tadtruex/PiPico/AirCar/kicad/AirCar-Proto/AirCar-Proto.kicad_pcb

## KiCad design AirCar/kicad/AirCar-Proto/AirCar-Proto.kicad_pcb (2024-01-03)

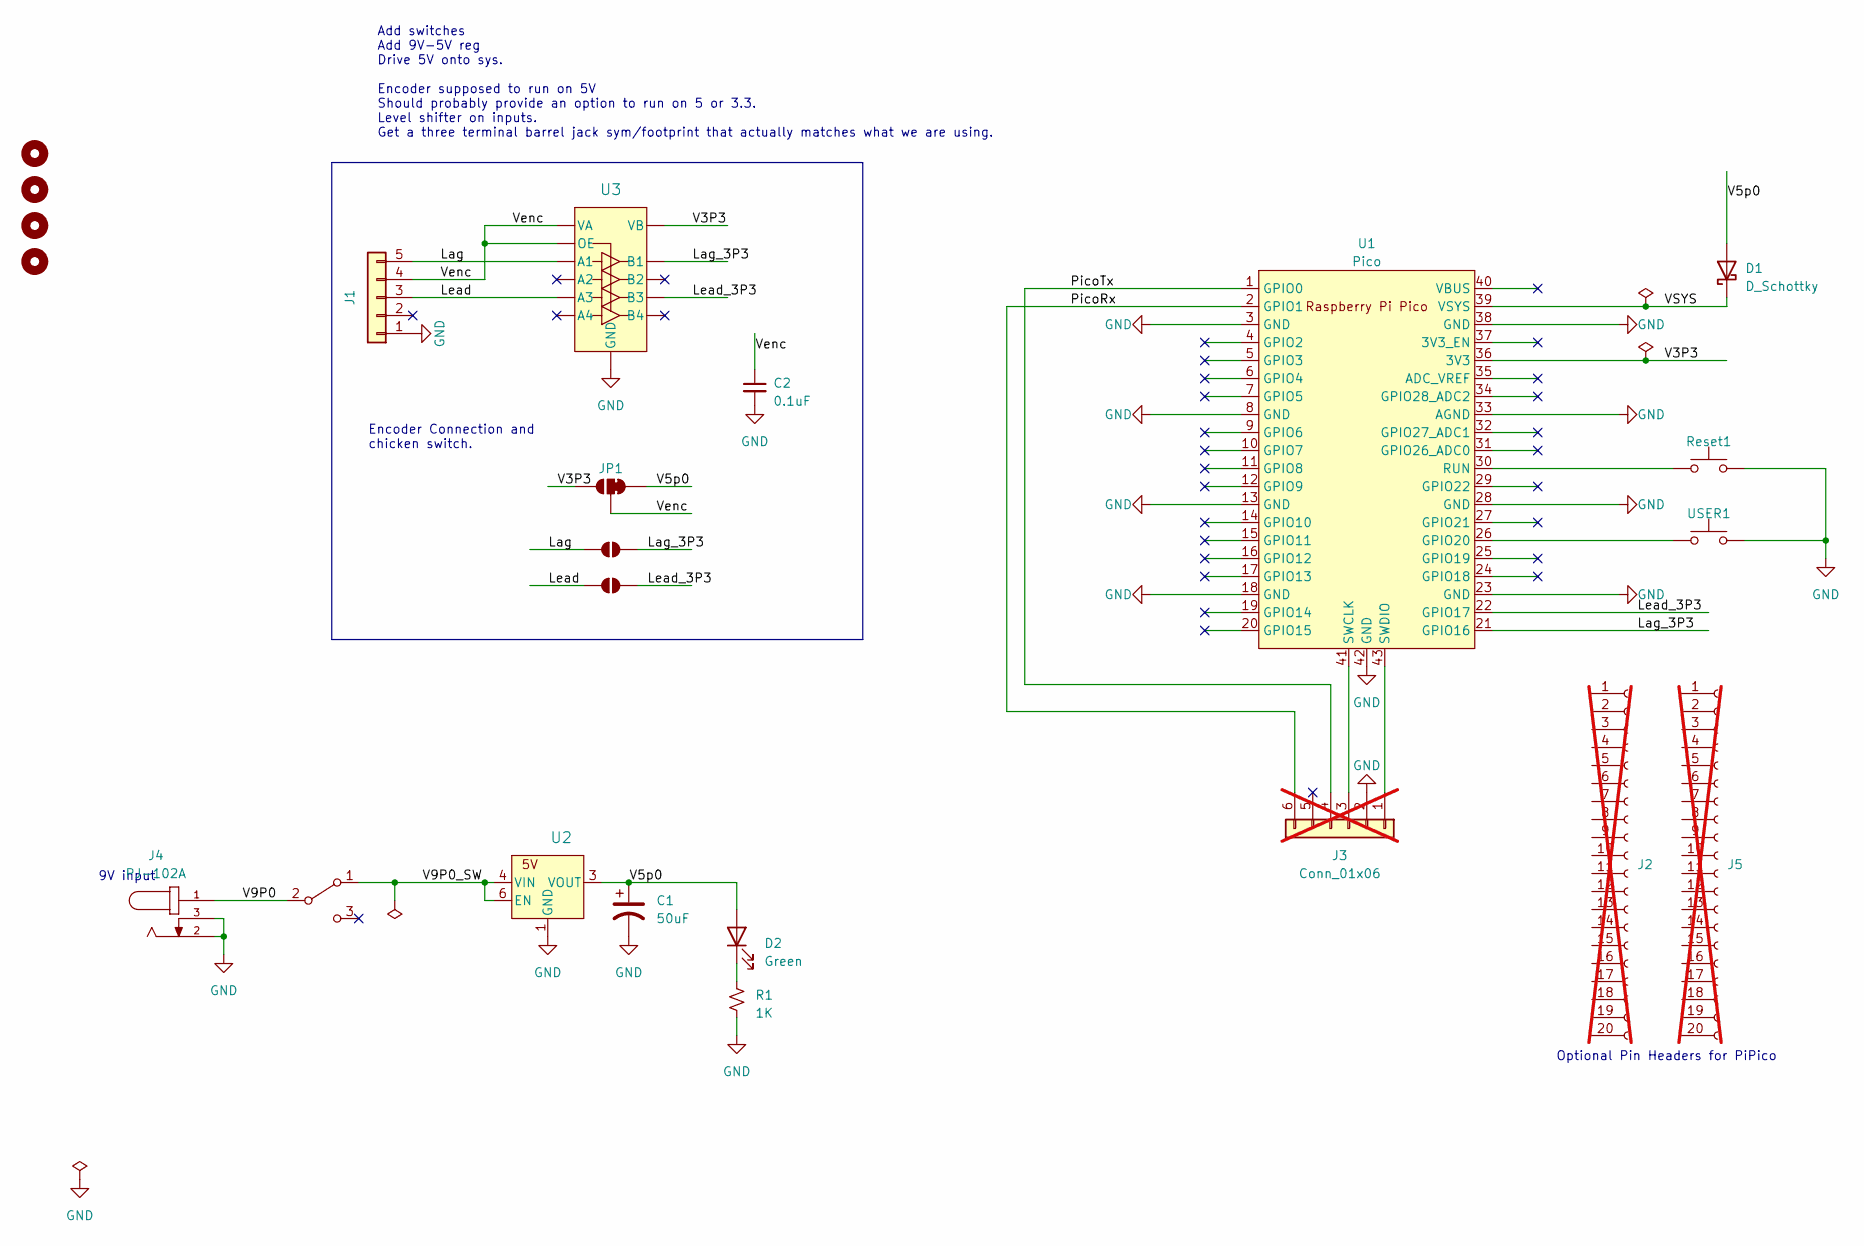
[picture p1: schematic AirCar-Proto.kicad_sch]

Parts:
C1: 50uF; CP_Radial_D8.0mm_P2.50mm
C2: 0.1uF; C_0603_1608Metric
D1: D_Schottky; D_SOD-123F; Digikey CRS01QCT-ND
D2: Green; LED_D5.0mm
H1, H2, H3, H4: MountingHole; MountingHole_3.2mm_M3
J1: Conn_01x05; PinHeader_1x05_P2.54mm_Horizontal; Digikey WM4903-ND
J2, J5: Conn_01x20_Socket; PinHeader_1x20_P2.54mm_Vertical; DigiKey 1212-1105-ND; not fitted
J3: Conn_01x06; PinHeader_1x06_P2.54mm_Horizontal; not fitted
J4: PJ-102A; BarrelJack_CUI_PJ-102AH_Horizontal; PART_REV 1.03
JP1: SolderJumper_3_Bridged12; SolderJumper-3_P1.3mm_Bridged12_RoundedPad1.0x1.5mm
JP2, JP3: SolderJumper_2_Open; SolderJumper-2_P1.3mm_Open_RoundedPad1.0x1.5mm
R1: 1K; R_0603_1608Metric
Reset1: SmallPushbutton; SW4_1825910-B_TEC; Digikey 450-1650-ND
SW2: SW_SPDT; CS12ANW03_NKK; Digikey 360-2131-ND
U1: Pico; RPi_Pico_SMD_TH; Digikey 2648-SC0915TR-ND
U2: LDL212PU50R; DFN-6-1EP_3x3mm_P0.95mm_EP1.7x2.6mm; Digikey 497-16897-2-ND
U3: TXU0104BQAR; U_TXU0104_TEX; Digikey 296-TXU0104BQARTR-ND
USER1: SmallPushbutton; SW4_1825910-B_TEC; Digikey 450-1650-ND

Connections:
/Lag: J1.5, JP2.1 (A), U3.2 (A1)
/Lag_3P3: JP2.2 (B), U1.21 (GPIO16), U3.13 (B1)
/Lead: J1.3, JP3.1 (A), U3.4 (A3)
/Lead_3P3: JP3.2 (B), U1.22 (GPIO17), U3.11 (B3)
/PicoRx: J3.6, U1.2 (GPIO1)
/PicoTx: J3.4, U1.1 (GPIO0)
/V3P3: JP1.3 (B), U1.36 (3V3), U3.14 (VB)
/V5p0: C1.1, D1.2 (A), D2.2 (A), JP1.1 (A), U2.2 (ADJ/sense), U2.3 (VOUT)
/V9P0: J4.1, SW2.2 (B)
/V9P0_SW: SW2.1 (A), U2.4 (VIN), U2.6 (EN)
/VSYS: D1.1 (K), U1.39 (VSYS)
/Venc: C2.1, J1.4, JP1.2 (C), U3.1 (VA), U3.8 (OE)
GND: C1.2, C2.2, J1.1, J3.2, J4.2, J4.3, R1.2, Reset1.3, Reset1.4, U1.3 (GND), U1.8 (GND), U1.13 (GND), U1.18 (GND), U1.23 (GND), U1.28 (GND), U1.33 (AGND), U1.38 (GND), U1.42 (GND), U2.1 (GND), U2.7 (GND), U3.7 (GND), U3.15 (GND), USER1.3, USER1.4
unnamed: D2.1 (K), R1.1
unnamed: J3.1, U1.43 (SWDIO)
unnamed: J3.3, U1.41 (SWCLK)
unnamed: U1.26 (GPIO20), USER1.1, USER1.2
unnamed: Reset1.1, Reset1.2, U1.30 (RUN)

Notes on the sheet:
Add switches Add 9V-5V reg Drive 5V onto sys. Encoder supposed to run on 5V Should probably provide an option to run on 5 or 3.3. Level shifter on inputs. Get a three terminal barrel jack sym/footprint that actually matches what we are using.
Optional Pin Headers for PiPico
9V input
Encoder Connection and chicken switch.

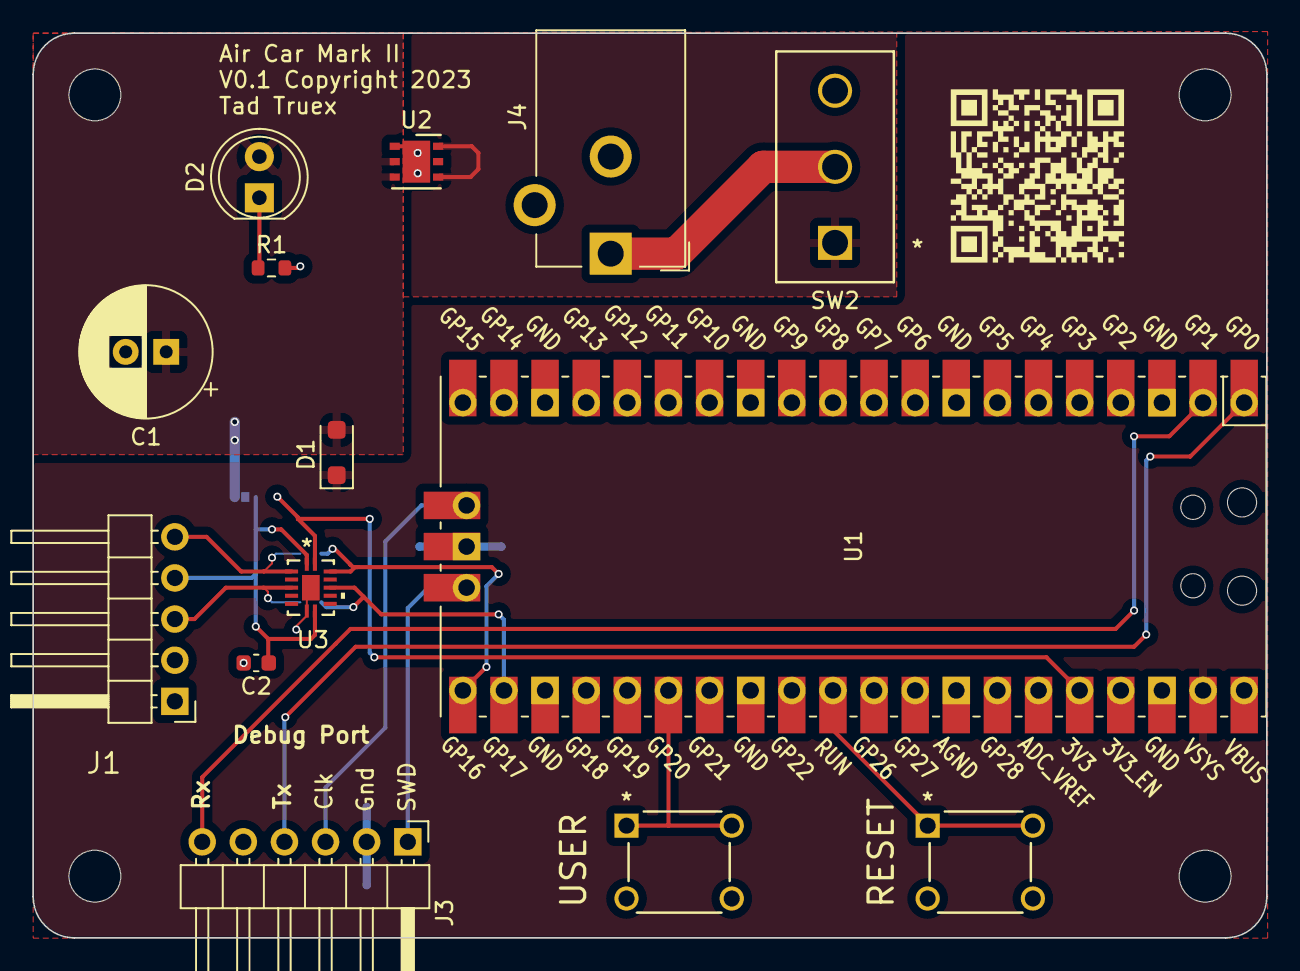
[picture p2: board AirCar-Proto.kicad_pcb from above]

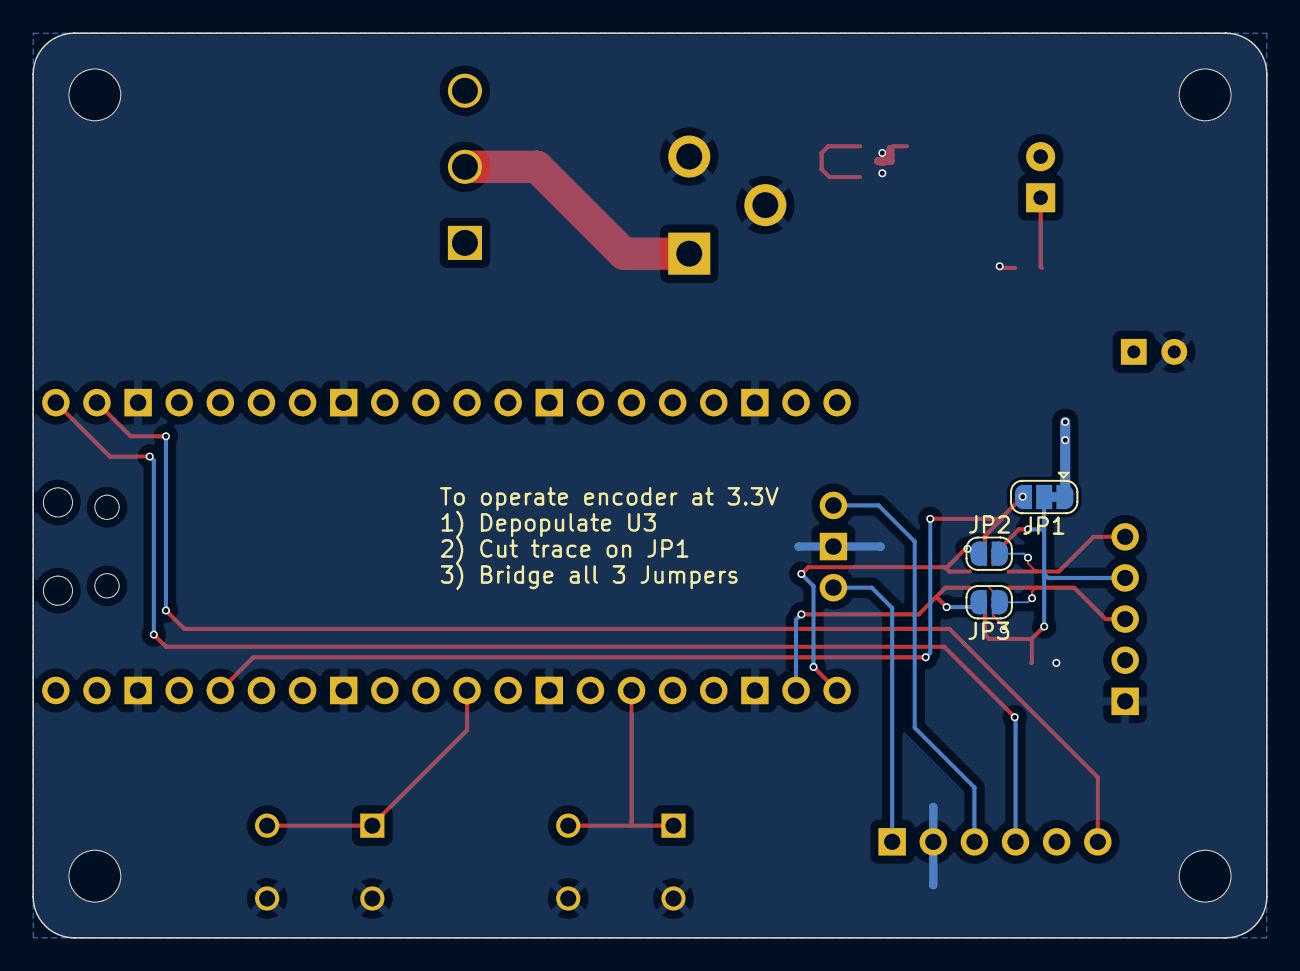
[picture p3: board AirCar-Proto.kicad_pcb from below]

Board: 2 copper layers, 76.2 x 55.9 mm, 21 parts (3 on the bottom side), 18 nets.
