tadtruex/PiPico/AirCar/aircar/aircar.c

/*
 * AirCar MarkII
 *
 * Tad Truex, F23
 *
 * Goals:
 * 	At a minimum, replicate the existing 8051 firmware.  Ideally,
 * 	modernize a bit, potentially adding additional sensors (accelerometer),
 * 	possibly a small display, an RTC, and (hopefully) eliminate the need for
 * 	9V battery.
 *
 * 	At a minimum
 *
 * 	1) Count the pulses from the rotary encoder.
 * 	2) Accurately record the value every 28.2uS (CHECK)
 * 	3) Appear as a USB-Drive when connected to a host.
 *
 *	Extras
 *	4) Add an oled display
 *	5) ??
 *
 *
 * 	Status: (Main status at https://github.com/users/tadtruex/projects/14)
 *
 * 	9/21: Pulse counting works fine.  The encoder is 360 PPR.  2.5"-ish
 * 	      diameter on a 16' track = 32 revolutions * 360 * 4 (quadrature) =
 * 	      46080 counts WC.  Signed int32_t is plenty.
 *
 * 	      Question:  The lab handout says 40 PPR - did Doug divide down to
 * 	      fit into an 8 bit number (it looks like the old data format is
 * 	      delta rather than absolute)
 *
 *      10/5: (V0.2) USB mass storage works fine.  It's a bit hokey because I only 
 *            store data for 1 file in memory, and it will re-appear even if
 *            it is deleted on the filesystem...  
 *
 *      1/4/24: Testing first prototypes back from manufacture.
 *            Reduce turn on delay to better catch initial transients.
 *            Reduce data collection by ~10%
 *
 *
 */



#include "pico/stdlib.h"
#include "hardware/gpio.h"
#include "hardware/clocks.h"
#include "hardware/pwm.h"
#include "hardware/flash.h"
#include <stdint.h>
#include <stdio.h>
#include <strings.h>

#include "bsp/board.h"
#include "ff.h"
#include <diskio.h>
#include <disk.h>
#include <ramdisk.h>

#include "version.h"


typedef struct _encoder {
	uint leadPinNum;
	uint lagPinNum;
} encoderT;

const encoderT encoder = { 17, 16 };


// Gray coded transitions on the encoder.
#define Quadrant0 ((uint8_t)(0))
#define Quadrant1 ((uint8_t)(2))
#define Quadrant2 ((uint8_t)(3))
#define Quadrant3 ((uint8_t)(1))


// Track the wheel rotations in a 30.2 format (quarter rotations)
volatile int32_t pulseCount30p2 = 0;
volatile int32_t nextRotationCount = 0x7fffffff;

// This system will start recording data after the encoder has
// inidicated the wheels have rotate this many degrees.
#define DEGREES_TO_START 45

// This seems to be what the old aircar did.
#define NUM_SAMPLES 720

// This is a bit of a magic number situation...
//
// We save the data in flash so it will be there in the event of an
//  "accident".  The erasing size is 4KB, so this is
// 1024 samples of uint32_t.  All a bit convoluted, but hopefully
// easy to tweak later if we want.

typedef uint32_t sample_t;
#define maxSamples (FLASH_SECTOR_SIZE / sizeof(sample_t))

volatile sample_t SampleBuffer[ maxSamples ];
#define DATA_OFFSET ((2 * 1<<20) - sizeof(SampleBuffer))
// We have 2MB (magic #) --+                 |
// We store our data at the end -------------+

#define DATA_START (uint8_t *)(XIP_BASE + DATA_OFFSET)
//                                |
// This is where flash starts ----+


volatile bool doWrite = false;

// Track the number of 28.2us pulses.
volatile int32_t counterTicks = 0;

// Track encoder errors
volatile uint32_t errorCount = 0;

// Interrupt handler for the encoder pin changes
void stateUpdate( uint gpio, uint32_t eventMask );

const uint led = PICO_DEFAULT_LED_PIN;

int do_test(void);

uint8_t pdisk[1<<15];


uint32_t millis;

void ledTask(uint32_t cycleTime);

void pwmInterrupt(void);

uint32_t msPerLedCycle = 5000;

BYTE buf[FF_MAX_SS];

void error( const char *buf ){
  printf( "%s\n", buf );
  while(1);
}

void initFS(void);
void writeDataFile( void );
FATFS fs;

int main() {

  pulseCount30p2 = 0;
  nextRotationCount = 0x7fffffff;
  doWrite = false;
  counterTicks = 0;
  errorCount = 0;
  
  
  board_init();

	gpio_init(led);
	gpio_set_dir(led, GPIO_OUT);
	gpio_put(led,1);

	// Prepare for some cave man debugging
	stdio_uart_init();

  // init device stack on configured roothub port
	tud_init(BOARD_TUD_RHPORT);

  initRamDisk();
  initFS();

  memcpy( (void *)SampleBuffer, DATA_START, sizeof( SampleBuffer ) );
  writeDataFile();
  
	gpio_init_mask(1<< encoder.lagPinNum | 1 << encoder.leadPinNum);

	// Remove this in production
	gpio_set_pulls(16, true, true);
	gpio_set_pulls(17, true, true);

    gpio_set_irq_enabled_with_callback(encoder.lagPinNum, GPIO_IRQ_EDGE_RISE | GPIO_IRQ_EDGE_FALL, true, &stateUpdate);
    gpio_set_irq_enabled_with_callback(encoder.leadPinNum, GPIO_IRQ_EDGE_RISE | GPIO_IRQ_EDGE_FALL, true, &stateUpdate);

    // This is not cool.  Using -28 here causes the chip to hang.
    //  Updating to -28 in the handler is fine.
    //add_repeating_timer_us( -100, timerFunc, NULL, &rt);

    // Use GPIO 4 (for now) as an indicator of interrupt entry.
    gpio_init(4);
    gpio_set_function(4, GPIO_FUNC_SIO);
    gpio_set_dir(4, GPIO_OUT);
    gpio_put(4, 0);
    
    uint slice_num = pwm_gpio_to_slice_num(4);

    // 125MHz cycle time for PWM clock.  3525 ticks gets us ~28.2us
    pwm_set_wrap(slice_num, 3524);

    // Set channel A output high for one cycle before dropping
    pwm_set_chan_level(slice_num, PWM_CHAN_A, 2000);

    // We're going to need an interrupt for this
    pwm_set_irq_enabled(slice_num, true);

    irq_set_exclusive_handler( PWM_IRQ_WRAP, pwmInterrupt );
    irq_set_priority( PWM_IRQ_WRAP, 0 );
    

    for( int i = 0; i < 26; i++ ) {
      if ( irq_is_enabled(i) ) {
	printf( "IRQ %d: %d\n", i, irq_get_priority(i) );
      }
    }

    msPerLedCycle = ~0;
    printf("Main loop start\n");
    
    while(1){
      millis = to_ms_since_boot( get_absolute_time() );

      // Start data collection after 1/4 rotation
      if ( pulseCount30p2 > DEGREES_TO_START<<2 && nextRotationCount == 0x7fffffff ) {
	msPerLedCycle = 0;
	nextRotationCount = pulseCount30p2 + 36;  // Nine degrees counting 1/4 degrees
	// Set the PWM running
	counterTicks = 0;
	pwm_set_enabled(slice_num, true);
	pwm_clear_irq(slice_num);
	irq_set_enabled(PWM_IRQ_WRAP, true);

	printf( "Sampling enabled\n" );
      }

      if ( doWrite ) {	
	uint32_t currentInterrupts;
	
	// Samples are currently stored as raw counts.  Need to convert to delta to match original
	//  firmware.
	for ( int i = NUM_SAMPLES-1; i > 0 ; i-- ) SampleBuffer[i] -= SampleBuffer[i-1];
	writeDataFile();

	// Copy the buffer to flash just in case
	currentInterrupts = save_and_disable_interrupts();
	flash_range_erase( DATA_OFFSET, sizeof(SampleBuffer) );
	flash_range_program( DATA_OFFSET, (uint8_t *)SampleBuffer, sizeof(SampleBuffer) );
	restore_interrupts(currentInterrupts);

	doWrite = false;
      }
      
      ledTask(msPerLedCycle);
      tud_task();
    }
}

void writeDataFile( void ) {
	FIL f;
	int n;
	int res;

	if (f_mount( &fs, "", 0 ) ) error("MOUNT");
	if ( (res=f_open( &f, "data.txt", FA_CREATE_ALWAYS | FA_WRITE ))) error( "File Open" );       

	for ( int i = 0; i < NUM_SAMPLES; i++ ) {
	  n = sprintf( buf, "%d\n", SampleBuffer[i] );
	  f_write( &f, buf, n, &n );
	  //	  printf( "%d\n", SampleBuffer[i] );
	}
	f_sync(&f);
	f_close(&f);
	printf("Closed and synced (%d errors)\n", errorCount);

}

void initFS(void) {

    FIL fil;

    int n;
    
    // Initialize the ram disk
    //if (f_fdisk(0, (LBA_t[]){100,0}, buf) ) error("FDISK");

    // Create a filesystem
    if (f_mkfs( "", 0, buf, FF_MAX_SS ) ) error("MKFS");

    if (f_mount( &fs, "", 0 ) ) error("MOUNT");

    if (f_open( &fil, "hello.txt", FA_CREATE_NEW | FA_WRITE )) error("FOPEN");

    /* Write a message */
    n = sprintf( buf, "%s", _version_str );
    f_write( &fil, buf, n, &n );
    
    /* Close the file */
    f_close(&fil);
    f_mount( 0, "", 0 );
}

void stateUpdate( uint gpio, uint32_t eventMask ){

  static uint8_t currentState = 0;
  static int sampleCount = 0;
  static bool done = false;
  static int caveman = 4;
  
  if ( !done ) {
    uint8_t nextState = 0;
    uint32_t pinState = gpio_get_all();
    
    nextState |= (pinState & (1<<encoder.lagPinNum))  ? 1 : 0 ;
    nextState |= (pinState & (1<<encoder.leadPinNum)) ? 2 : 0 ;

    switch ( currentState ) {
    case Quadrant0 :
      if (nextState == Quadrant1) { pulseCount30p2++; }
      if (nextState == Quadrant2) { errorCount++; }
      if (nextState == Quadrant3) { pulseCount30p2--; }
      break;
    case Quadrant1 :
      if (nextState == Quadrant2) { pulseCount30p2++; }
      if (nextState == Quadrant3) { errorCount++; }
      if (nextState == Quadrant0) { pulseCount30p2--; }
      break;
    case Quadrant2 :
      if (nextState == Quadrant3) { pulseCount30p2++; }
      if (nextState == Quadrant0) { errorCount++; }
      if (nextState == Quadrant1) { pulseCount30p2--; }
      break;
    case Quadrant3 :
      if (nextState == Quadrant0) { pulseCount30p2++; }
      if (nextState == Quadrant1) { errorCount++; }
      if (nextState == Quadrant2) { pulseCount30p2--; }
      break;
    }

    currentState = nextState;

    if ( caveman ){
      printf( "%d\n", currentState );
      caveman--;
    }
    
    if ( pulseCount30p2 > nextRotationCount ) {
      SampleBuffer[sampleCount++] = counterTicks;
      nextRotationCount += 36;  // 9 degrees
      if ( sampleCount == NUM_SAMPLES ) {
	done = true;
	doWrite = true;
	msPerLedCycle = 500;
	printf( "Sampling complete\n");
      }
    }
  }
}

void pwmInterrupt( void ) {
  counterTicks++;
  gpio_put( 4, !gpio_get(4) );
  pwm_clear_irq(pwm_gpio_to_slice_num(4));
}

  
void ledTask( uint32_t msPerCycle ) {
  static uint32_t lastMillis = 0;

  if ( msPerCycle == 0 ) {
    gpio_put(led, 0);
  } else if ( msPerCycle == ~0 ) {
    gpio_put(led, 1);
  } else if ( millis - lastMillis > msPerCycle>>2 ) {
    lastMillis = millis;
    gpio_put( led, !gpio_get(led) );
  }
}
