tadtruex/PiPico/AirCar/aircar/usb/src/msc_disk_dual.c

/* 
 * The MIT License (MIT)
 *
 * Copyright (c) 2019 Ha Thach (tinyusb.org)
 *
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
 */

#include "bsp/board.h"
#include "tusb.h"

#include "ff.h"
#include "diskio.h"

#if CFG_TUD_MSC

// When button is pressed, LUN1 will be set to not ready to simulate
// medium not present (e.g SD card removed)

// Some MCU doesn't have enough 8KB SRAM to store the whole disk
// We will use Flash as read-only disk with board that has
// CFG_EXAMPLE_MSC_READONLY defined

enum
{
  DISK_BLOCK_NUM  = 256, // 8KB is the smallest size that windows allow to mount
  DISK_BLOCK_SIZE = 512
};

// Cheesy, but easier to change later...
BYTE pdev = 0;


//--------------------------------------------------------------------+
// LUN 0
//--------------------------------------------------------------------+
#define README0_CONTENTS \
"LUN0: This is tinyusb's MassStorage Class demo.\r\n\r\n\
If you find any bugs or get any questions, feel free to file an\r\n\
issue at github.com/hathach/tinyusb"


#ifdef CFG_EXAMPLE_MSC_READONLY
const
#endif

// Invoked to determine max LUN
uint8_t tud_msc_get_maxlun_cb(void)
{
  return 1; // just 1
}

// Invoked when received SCSI_CMD_INQUIRY
// Application fill vendor id, product id and revision with string up to 8, 16, 4 characters respectively
void tud_msc_inquiry_cb(uint8_t lun, uint8_t vendor_id[8], uint8_t product_id[16], uint8_t product_rev[4])
{
  (void) lun; // use same ID for both LUNs

  const char vid[] = "AirCar";
  const char pid[] = "Mass Storage";
  const char rev[] = "1.0";

  memcpy(vendor_id  , vid, strlen(vid));
  memcpy(product_id , pid, strlen(pid));
  memcpy(product_rev, rev, strlen(rev));
}

// Invoked when received Test Unit Ready command.
// return true allowing host to read/write this LUN e.g SD card inserted
bool tud_msc_test_unit_ready_cb(uint8_t lun)
{
  return true; // RAM disk is always ready
}

// Invoked when received SCSI_CMD_READ_CAPACITY_10 and SCSI_CMD_READ_FORMAT_CAPACITY to determine the disk size
// Application update block count and block size
void tud_msc_capacity_cb(uint8_t lun, uint32_t* block_count, uint16_t* block_size)
{
  (void) lun;

  disk_ioctl( pdev, GET_SECTOR_SIZE, block_size );
  disk_ioctl( pdev, GET_SECTOR_COUNT, block_count );
  
}

// Invoked when received Start Stop Unit command
// - Start = 0 : stopped power mode, if load_eject = 1 : unload disk storage
// - Start = 1 : active mode, if load_eject = 1 : load disk storage
bool tud_msc_start_stop_cb(uint8_t lun, uint8_t power_condition, bool start, bool load_eject)
{
  (void) lun;
  (void) power_condition;

  if ( load_eject )
  {
    if (start)
    {
      // load disk storage
    }else
    {
      // unload disk storage
    }
  }

  return true;
}

// Callback invoked when received READ10 command.
// Copy disk's data to buffer (up to bufsize) and return number of copied bytes.
int32_t tud_msc_read10_cb(uint8_t lun, uint32_t lba, uint32_t offset, void* buffer, uint32_t bufsize)
{
  (void) lun;
  
  // out of ramdisk
  if ( lba >= DISK_BLOCK_NUM )
    return -1;

  if ( bufsize != 512 || offset != 0 )
    return -1;

  disk_read( pdev, buffer, lba, 1 );
  
  return (int32_t) bufsize;
}

bool tud_msc_is_writable_cb (uint8_t lun)
{
  (void) lun;

  return true;
}

// Callback invoked when received WRITE10 command.
// Process data in buffer to disk's storage and return number of written bytes
int32_t tud_msc_write10_cb(uint8_t lun, uint32_t lba, uint32_t offset, uint8_t* buffer, uint32_t bufsize)
{
  (void) lun;
  
  // out of ramdisk
  if ( lba >= DISK_BLOCK_NUM )
    return -1;
  
  if ( bufsize != 512 || offset != 0 )
    return -1;

  disk_write( pdev, buffer, lba, 1 );
  
  return (int32_t) bufsize;
}

// Callback invoked when received an SCSI command not in built-in list below
// - READ_CAPACITY10, READ_FORMAT_CAPACITY, INQUIRY, MODE_SENSE6, REQUEST_SENSE
// - READ10 and WRITE10 has their own callbacks
int32_t tud_msc_scsi_cb (uint8_t lun, uint8_t const scsi_cmd[16], void* buffer, uint16_t bufsize)
{
  // read10 & write10 has their own callback and MUST not be handled here

  void const* response = NULL;
  int32_t resplen = 0;

  // most scsi handled is input
  bool in_xfer = true;

  switch (scsi_cmd[0])
  {
    default:
      // Set Sense = Invalid Command Operation
      tud_msc_set_sense(lun, SCSI_SENSE_ILLEGAL_REQUEST, 0x20, 0x00);

      // negative means error -> tinyusb could stall and/or response with failed status
      resplen = -1;
    break;
  }

  // return resplen must not larger than bufsize
  if ( resplen > bufsize ) resplen = bufsize;

  if ( response && (resplen > 0) )
  {
    if(in_xfer)
    {
      memcpy(buffer, response, (size_t) resplen);
    }else
    {
      // SCSI output
    }
  }

  return resplen;
}

#endif
