tadtruex/PiPico/(commit log)

2023-09-20 Start playing with interrupt handler
2023-09-21 work on encoder
2023-09-22 start adding timer
2023-09-22 Start working on timer functionality.
    Start to address #8
2023-09-22 add heartbeat and work around bug - sample rate is 28us
    [aircar.c]
2023-09-25 Add pwm lib to CMake
    Use PWM to generate 28.2us square-ish wave on pin 4.
    Partially addresses #8
2023-09-26 Finally find the magic required to get something with both pico-sdk and tinyusb to compile.
2023-09-26 aircar now appears as a usb device (actually 2). Cribbed most of the code from the tinyusb libraries example code.
    There are currently no callbacks implemented and no real filesystem.
    Closes #3
2023-09-26 This add the fatfs everyone seems to use. Ultimately can probably move it out of the local area as it is included in tinyusb.
    Start fleshing out a ram disk driver.
    Close #11
    Work on #12
2023-09-27 Flesh out the ramdisk driver. Passes the fatfs driver test (which isn't too demanding)
2023-09-28 start adding interrupt
2023-09-29 Make the PWM interrupt highest priority and enable it.
    Timebase is not very accurate when compiled for debug, so don't do that
    anymore...
    cmake --build -DCMAKE_BUILD_TYPE=Release
2023-09-29 This is broken. There seems to be some sort of interaction between the PWM interrupt and the rest of the system, particulary UART stdio...
    [aircar.c]
2023-10-02 fix the pwm interrupt. Now need to process data before fwriting it
    [aircar.c]
2023-10-02 Quirky but worky.
    Basically works OK. A few issues.
    1) It doesn't appear possible (or easy at least) to cause the host computer
    to re-read the disk after it is inserted. This makes development a bit of a pain...
    Probably possibly to have it disconnect in software, but not sure.
    Anyway - this firmware seems to track that on Car F very closely. Need some testing
    and breaking, but should be close.
    Close #9
    Close #5
    Close #12
    [aircar.c, msc_disk_dual.c]
2023-10-03 add start of schematic
    [AirCar-Proto.kicad_pcb, AirCar-Proto.kicad_sch]
2023-10-04 Add rudimentary schematic for proto-board version.
    Note: This schematic runs the rotary encoder below it's minimum
    VDD value. It seems to work fine (as it should), but it may be
    flaky.
    This fixes a bug in the stateUpdate logic that manifests when the
    lead pin is higher (pin number) than the lag pin.
    [AirCar-Proto.kicad_sch]
2023-10-04 turn led off when collecting data
2023-12-01 start working on board
    [AirCar-Proto.kicad_pcb, AirCar-Proto.kicad_sch, AirCar.kicad_pcb, AirCar.kicad_sch]
2023-12-11 work on proto
    [AirCar-Proto.kicad_pcb, AirCar-Proto.kicad_sch]
2023-12-11 Good start.
    Need to add 3v/5v option for encoder.
    [AirCar-Proto.kicad_pcb, AirCar-Proto.kicad_sch]
2023-12-12 works w/ 3.3v encoder
    [AirCar-Proto.kicad_pcb]
2023-12-13 work on adding level shifter
    [AirCar-Proto.kicad_pcb, AirCar-Proto.kicad_sch]
2023-12-15 switch to some none through hole parts because SMD is easier...
    [AirCar-Proto.kicad_pcb, AirCar-Proto.kicad_sch]
2023-12-15 possible rev 0.1 candidate
    [AirCar-Proto.kicad_pcb, AirCar-Proto.kicad_sch]
2023-12-15 Gerbers for initial proto
    [AirCar-Proto.kicad_pcb, AirCar-Proto.kicad_sch]
2023-12-18 remove small vias for JLCPCB
    [AirCar-Proto-B_Cu.gbr, AirCar-Proto-B_Mask.gbr, AirCar-Proto-B_Paste.gbr, AirCar-Proto-B_Silkscreen.gbr, AirCar-Proto-Edge_Cuts.gbr, AirCar-Proto-F_Cu.gbr, AirCar-Proto-F_Mask.gbr, AirCar-Proto-F_Paste.gbr]
2023-12-27 add pin headers and BOM
    [AirCar-Proto.csv, AirCar-Proto.kicad_sch]
2024-01-04 Reduce data to 720 samples ( -10% )
    Reduce start delay to 45 degrees.
