tadtruex/PiPico/(notices)

Notices in the files:
AirCar/kicad/AirCar-Proto/AirCar-Proto.kicad_pcb:
V0.1 Copyright 2023
